alexrus/marax_timer/(threads)

Thread 3 (2021-01-20):

Timer does not (?) take into account the 500ms delay from 1st read

jousis9, 2021-01-20:
Hi 👋

In order to stop the timer we have to wait for (at least) a period of the pump (because of the reed sensor pulsing).
You calculated this to be 500ms.

But, since we waited 500ms from our 1st 0 read, I think those 500ms need to be subtracted from the timer afterwards.
Or, am I missing something ?

For example, instead of stoping the timer at millis:
`timerDisplayOffMillis = millis();`

You should stop it at:
`timerDisplayOffMillis = millis() - 500;`

or better (?) take the millis we had the 1st 0 as the actual stop time?
`timerDisplayOffMillis  = timerStopMillis;`

jousis9, 2021-01-20:
Nope, misread this section completely, you use this only for timeout, not for previous timer storage, sorry !!!

Closed 2021-01-20.

Thread 5 (2021-12-19):

Randomly get weird characters instead of temp

natewalck, 2021-12-19:
The timer is working super well and I can see the temp sometimes, but it is rotates between the temp and garbage Unicode characters.

Attached is a video of what I mean.

Not sure if this is a bad crimp or a software issue.

https://user-images.githubusercontent.com/867868/146681369-37664653-5ebd-4e7a-878d-3246750536f5.MOV

Coolby81, 2021-12-19:
I have seen same things but very rarely only when I turn on or off the machine and for a very short time.

rubdom, 2021-12-19:
I get the same during brewing. It could be caused by being underpowered?  I haven’t tried to swap the power supply yet.

natewalck, 2021-12-19:
I'm using the microusb for power with an iPhone charger plug. Not sure if this is sufficient or not, but I believe it has enough amps.

Coolby81, 2021-12-19:
I would guess it is more of an issue on the maraX side, probably false reading from the sensors or bad characters in the simple text message. Somehow the raw data should be checked.
I am also using a simple power supply from a wyze cam now. And I am powering through the pins and not through the usb port of the esp.
I had issues with flashing led (same as when the pump is running and the reed is active) even if the machine was turned off. I had the machine and the esp on the same 3-way socket with own usb outputs, so that I can turn everything on and off with a smart plug. But somehow the esp was flashing even with no power on it. So I swithed the socket usb port to a wyze power supply and the issue seems disappearing.

natewalck, 2021-12-19:
I was thinking the same on junk in the serial data. If we filter junk out, then that could lead to a less frequent update depending how many bad bytes we get. I guess this is acceptable for me anyways as I mainly use it to confirm I am up to temp. I may give that a try and do a PR.

alexrus, 2021-12-19:
I encountered this issue a few times in the past, but it was totally random, so I investigated a bit and the issue is that I'm waiting for a stream of data from maraX in the correct format, but the machine sends it otherwise. This can happen if the machine sends the endMarker (\n) during the transmission

We read it here: https://github.com/alexrus/marax_timer/blob/main/timer/timer.ino#L60

take a look here (https://github.com/alexrus/marax_timer/blob/main/timer/timer.ino#L74) and see how the data is coming back from the machine

alexrus, 2021-12-19:
I am powering my esp from an old iPhone charger, should have plenty of power for what it needs

natewalck, 2021-12-19:
Looks like I am getting the following over serial:

```
$⸮/ ⸮ ⸮s⸮ C123b,120,112,097,0000,0
C123b,120,112,097,0000,0
C123b,120,112,097,0000,0
C123b,120,112,097,0000,0
C123b,120,112,097,0000,0
C123b,120,112,097,0000,0
C123b,120,112,097,0000,0
C123b,120,112,097,0000,0
C123b,120,112,097,0000,0
C123b,120,112,097,0000,0
C123b,120,112,097,0000,0
C123b,120,112,097,0000,0
C123b,120,112,097,0000,0
C123b,120,112,097,0000,0
C123b,120,112,097,0000,0
C123b,120,112,097,0000,0
⸮⸮ 120,112,097,0000,0
```

Every now and again we get a `⸮⸮ 119,112,097,0000,0`

PR #6 Should handle this case in a quick a dirty way.

natewalck, 2021-12-19:
Interestingly enough, it worked perfectly when plugged up to the laptop, but now that it is back on a power brick, its doing the same exact thing 🙄

I'll poke it some more.

natewalck, 2021-12-19:
Here is more info on this. Plugged into my laptop, it works perfectly. Plugged into a power brick, it does the funky behavior.

Laptop:
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

5V 2.4A iPad charger:
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

😕  The only real difference I can think of is that on the laptop, it is attached as a serial device. I tried commenting out all the Serial.println calls and that didn't change this at all.

natewalck, 2021-12-19:
Here is more info on this. Plugged into my laptop, it works perfectly. Plugged into a power brick, it does the funky behavior.

Laptop:
https://www.dropbox.com/s/mb9nw8q6npp0grh/IMG_3086.MOV?dl=0

5V 2.4A iPad charger:
https://www.dropbox.com/s/mb9nw8q6npp0grh/IMG_3086.MOV?dl=0

😕  The only real difference I can think of is that on the laptop, it is attached as a serial device. I tried commenting out all the Serial.println calls and that didn't change this at all.

natewalck, 2021-12-19:
Alright, should be the final update on this:

Even the 5V 2.4A plug was *not* enough. I used a Anker QI USB brick that I had kicking around and the display issues instantly disappeared. I wonder if the other plugs were also more dirty, electrically.

Closed 2021-12-19.

Thread 7 (2022-03-13):

Additional Hardware Information

mhellmeier, 2022-03-13:
It would be great if the README can be extended with detailed hardware information.
Currently, the list contains the following information:
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

These questions remain open:

1. Are there any preferred NodeMCU ESP8266 boards? Like CH340G, CP2102, CH9102X, ...
2. The linked 3D case is made for an SH1306 OLED display. Which is the correct one: the original, big one on the blue-colored board or the new smaller one on the black/dark-grey board?
3. Which reed sensor type is the correct one: open or closed?

alexrus, 2022-03-14:
@mhellmeier
1. I don't think there are prefered variants, as long as it has an esp8266 the code should work
2. the oled displayed used in the wiring diagram, is a diagram, that was the one I used to show the wiring. ofc, you need to use an oled display tha tis compatible with the 3d printed case. as long as it has i2c any oled display should work
3. I think it's normal open

Closed 2022-08-08.

Thread 8 (2022-08-06):

Temperature section shoes different letters

NormanB88, 2022-08-06:
Hi. I followed your instructions to create a shot timer. It works create, but the temperature section shows a lot ot different letters and doesn't show the correct temperature. Sometimes it works. Mostley not. Do you have am idea whats wrong?

NormanB88, 2022-08-06:
https://youtube.com/shorts/23GFZMBMst0?feature=share

For example

rubdom, 2022-08-06:
> https://youtube.com/shorts/23GFZMBMst0?feature=share
>
> For example

Try a stronger power supply. I had the same issues and that fixed it.

NormanB88, 2022-08-06:
Holy shit. You made my day!

NormanB88, 2022-08-06:
I Know after one hour the display shuts down, is it possible to change shut down time earlier in the code?

alexrus, 2022-08-08:
yes, check this line: https://github.com/alexrus/marax_timer/blob/main/timer/timer.ino#L108

1000 * 60 * 60 is 1 hour in miliseconds

JoghurtBecher88, 2022-10-04:
I had the same issue in the Temperature section. Different letters showing. Using a 1331 color Oled with a Modified sketch to run the Oled. Mara X Pins are D6 and D1. Using a strong enough Power Supply or the 5v directly on the Board doesnt change anything.  Any Suggestions?

Thread 9 (2022-08-16):

lever direction reversed

clingergab, 2022-08-16:
Hey thanks for posting this. Everything worked fine until I connected pins 3 and 4 to the board. if i have it set up without them everything works great, the timer goes on and off perfectly. but when I connect pins 3 and 4 to D5 and D6 (or the other way around) this causes the machine to reverse the pump flow, so water comes out when the lever is lowered, and stops coming out when the lever is down. Any ideas why? Thanks!
edit: its the OPV discharge that water is coming out of not the water head.

alexrus, 2022-08-17:
I have no idea why this would happen. pins 3&4 are data pins, so serial data is transmitted over them.
In the readme I mentioned to reverse them in case if does not work, because if you start counting from the left or right the order is the different one. Reversing them should not do this,  because there is no message sent to tell it to do so. My advice is to try with another nodeMCU board.

clingergab, 2022-08-18:
Thanks for getting back to me. Yeah thats kinda wierd. I'll contact the lelit support and see if they have any info. on another note do you know if I should be able to connect to a 1.3" display with same number of pixels? or would I need to change anything in the code?

alexrus, 2022-08-18:
you can connect any display that uses this driver: https://github.com/adafruit/Adafruit_SSD1306

If you have a non-compatible display, you probably need to use a different driver for it.

Closed 2022-08-22.

Thread 10 (2022-10-02):

Timer immediately starts

mhellmeier, 2022-10-02:
I just set up the board and installed the reed sensor as described in the `README`.

After starting the Mara X machine and the board, the timer immediately starts counting, although the pump has not started yet. When starting or stopping the pump, the timer keeps counting and doesn't stop.

Any ideas on what causes the problem and how to fix it?

EssayAssay, 2022-10-02:
Hi,

Make sure the switch is connected properly to the board.

If MaraX is off, does the time start counting?

alexrus, 2022-10-02:
Hi,

Make sure the switch is connected properly to the board.

If MaraX is off, does the time start counting?

mhellmeier, 2022-10-03:
> If MaraX is off, does the time start counting?

Yes, the timer starts even if the Mara X is off.

rubdom, 2022-10-03:
> > If MaraX is off, does the time start counting?
>
> Yes, the timer starts even if the Mara X is off.

Maybe the wrong kind of reed switch?  Did you buy a normally open or normally closed switch?

alexrus, 2022-10-03:
I think inverting the value should be fine ... give it a try

mhellmeier, 2022-10-10:
Yep, inverting the value solved the problem for me!

I will create a pull request with different versions for different reed switches.

Thread 13 (2022-11-06):

which reed sensor did you use exactly?  Mine worked for 2 days and then it stopped working.  It works when dismantled.

SvenGruhn, 2022-11-06:

alexrus, 2022-11-07:
I would check other connections maybe? I used a NO sensor

mccmax1395, 2023-10-31:
Do you have a recommendation for a specific reed sensor?  I'm trying to use [this](https://www.aliexpress.us/item/2255800342365165.html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) one and it's constantly flipping between on and off when the pump is engaged.

alexrus, 2023-10-31:
try this one: https://www.aliexpress.us/item/1005001309886250.html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

mccmax1395, 2023-10-31:
Ordered, thanks for the recommendation

mccmax1395, 2023-11-13:
Hi just wanted to update on this for anyone else who is having this issue.  The new reed sensor had the same problem however, I found a way to fix it.  I am adapting this script into ESPHome and I fixed the problem by adding a 1 second delay to turning the bool associated to the reed sensor off.  You can find details [here](https://esphome.io/components/binary_sensor/index.html#delayed-off).  thanks for your prompt response @alexrus and for putting this repo together, it was extremely helpful.

Closed 2023-12-05.

Thread 15 (2022-11-15):

Also compatible to MaraT?

janpfischer, 2022-11-15:
Hi all,

thanks for this, this is looking great!
Currently I am planning to either purchase the MaraX or MaraT. The only difference I've spotted on the MaraT is that this has a PID installed. But does anyone know if the MaraT has also the 6 PIN Serial connector? Would be great to also get those readings.

Thanks!

alexrus, 2023-12-06:
No idea if it has the 6 pin connector

Closed 2023-12-06.

Thread 16 (2022-12-28):

GND-Connection between ESP and Mara?

ShuzzDE, 2022-12-28:
Hi!
I'm wondering how the serial communication is supposed to work since there doesn't seem to be any GND connection between the MCU and the coffee machine?
Looking at code and documentation, only the RX and TX lines seem to be connected - no GND.

I'd like to understand how this is supposed to work before trying to build it.

Best regards!

alexrus, 2022-12-30:
Well, I can't explain, but I think you can connect the ground as well, if you know what is the GND pin on the MaraX

alexrus, 2023-01-05:
Yeah, I have no idea what the GND pin is

bancbanus, 2023-01-05:
Hi ShuzzDE,

I'm also wondering what type of connection it is. Watching LelitInsider's video I've seen that he is connecting a 4-wire-cable, so it looks like a standard full duplex serial connection (see https://youtu.be/9NL6yeq7sMM )

In all projects on github pin 3 is assumed as RX and pin 4 as TX (see https://github.com/bancbanus/marax_monitor/blob/main/hardware/marax_control_box.png). I've seen that Alexrus is sending data to the RX pin, but in my tests this doesn't have any effect. Maybe pin 3 is the GND pin?

You said that you were trying to find out the GND pin? Can you tell me how you did it? Did you use the multimeter? A logic analyzer or an oscilloscope?

I didn't want to brick the coffee machine (and upset my wife), that's why I didn't do any further investigations. I would be pleased if you can share your insights :-)

I would also like to know if there is a Vout pin which can be used to power the ESP32. Maybe the first pin? Because all V+ pins are labelled as squares on the control box' schematic.

Best regards!

alexrus, 2023-01-06:
Actually I think it should be easy to find out.

MaraX has a 6 pin connector, we are using pins 3&4 for RX or TX (but not sure if 3 is RX or TX, depends if you start left to right or right to left)

The standard pinout is 5V, GND, RX, TX, RTS, CTS. So GND should be next to RX

bancbanus, 2023-01-09:
Hi Alex,

thank you for your answer and yes, you're right :-)

The pinout (from the center to the edge) is most probably 5V, GND, RX, TX, RTS, CTS

BTW it has also been confirmed by larszi who realized a very impressive mod: https://github.com/larszi/marax-pressure-mod

Closed 2023-12-05.

Thread 18 (2023-12-05):

Fatal error when trying to program in Arduino IDE

hanism11, 2023-12-05:
I got this message when i copied the code provided and uploaded onto my Arduino board. Any help?

C:\Users\Admin\AppData\Local\Temp\.arduinoIDE-unsaved2023115-20396-10iotpg.0ay2\sketch_dec5c\sketch_dec5c.ino:7:10: fatal error: Adafruit_SSD1306.h: No such file or directory
    7 | #include <Adafruit_SSD1306.h>
      |          ^~~~~~~~~~~~~~~~~~~~
compilation terminated.

exit status 1

Compilation error: Adafruit_SSD1306.h: No such file or directory

alexrus, 2023-12-05:
Please install the dependencies listed at the bottom of the page: https://github.com/alexrus/marax_timer#dependencies

hanism11, 2023-12-05:
> Please install the dependencies listed at the bottom of the page: https://github.com/alexrus/marax_timer#dependencies

I've done that and now i've got a new error message again. I'm an absolute beginner to Arduino or any board programming so i need all the help i can get. I have only gotten this board today and are trying to program it. I however had not soldered any wires to the board.

C:\Users\Admin\AppData\Local\Arduino15\packages\esp8266\hardware\esp8266\3.1.2\libraries\Wire\Wire.cpp:38:2: error: #error Wire library is not supported on this board
   38 | #error Wire library is not supported on this board
      |  ^~~~~
C:\Users\Admin\AppData\Local\Arduino15\packages\esp8266\hardware\esp8266\3.1.2\libraries\Wire\Wire.cpp:56:30: error: 'SDA' was not declared in this scope
   56 | static int default_sda_pin = SDA;
      |                              ^~~
C:\Users\Admin\AppData\Local\Arduino15\packages\esp8266\hardware\esp8266\3.1.2\libraries\Wire\Wire.cpp:57:30: error: 'SCL' was not declared in this scope; did you mean 'SCK'?
   57 | static int default_scl_pin = SCL;
      |                              ^~~
      |                              SCK

exit status 1

Compilation error: exit status 1

alexrus, 2023-12-05:
What board is this?

hanism11, 2023-12-05:
> What board is this?

Its an ESP8266NODEMCU board i got from Aliexpress.

https://www.aliexpress.com/item/1005005077804800.html?spm=a2g0o.order_list.order_list_main.40.20f01802SUVEkm

alexrus, 2023-12-05:
I think the first error is self explanatory: #error Wire library is not supported on this board

Check how you can configure the board to work with arduino app maybe?

hanism11, 2023-12-05:
Any suggestion on a board that actually works? I really have no experience with all these.

alexrus, 2023-12-05:
try NodeMCU V2 CP2102

alexrus, 2023-12-06:
yes, that should be it

hanism11, 2023-12-06:
> yes, that should be it

I tried another cable today and it worked! Managed to upload the code onto the board. Now all i need is my LCD display to test it out.

On the reed switch is there a specific way to wire it? Since it has two sides or does it not matter?

alexrus, 2023-12-06:
it should not matter

Closed 2024-02-27.

Thread 19 (2024-02-27):

Display on SH1306

hanism11, 2024-02-27:
How do i change the code to make the text for a SH1306?

After i’ve 3D printed the case as per the link that i realized the 0.96” OLED won’t fit as the case is way to big for it. Instead of going for another 3D print i reckon it will be easier for me to get a SH1306 instead

alexrus, 2024-02-27:
I haven't used SH1306 ...

hanism11, 2024-02-27:
Fully understood. Just that from the link you provided the case was for a SH1306 which is way too big for the 0.96” OLED

alexrus, 2024-02-27:
You mean this link: https://www.thingiverse.com/thing:2937731 ?

There there are multiple files for I think 3 monitor sizes

hanism11, 2024-02-27:
No unfortunately the difference sizes are the same. He included one for the Lolin which is a much bigger board but as for screen wise the only difference was different mounting points.

hanism11, 2024-02-27:
oh my apologies he did include one for the 0.96'' OLED. I shall try again then
