alexrus/marax_timer/(commit log)

2020-10-25 show only timer when pump is active
2021-01-09 indicate if machine is in fast heating mode by rectangle instead of circle symbol
2021-01-09 reset timer count to 0 when going to sleep
    [timer.ino]
2022-10-10 Support different reed sensor types and update README
2022-10-12 Change default reed sensor value
2022-10-28 Update timer.ino
    Missing ";" in 92 + 94
    [timer.ino]
